parkourlrc/pcb-Pai-88--emg-robotic-hand-2f7e73264c/board/revd/kicad/release_20260804/bom.csv

Refs | Value | Footprint | Qty
C1,C2,C4,C6 | 100n | Capacitor_THT:C_Disc_D5.0mm_W2.5mm_P5.00mm | 4
C3 | 1u | Capacitor_THT:C_Rect_L7.0mm_W2.0mm_P5.00mm | 1
C5 | 10u | Capacitor_THT:CP_Radial_D5.0mm_P2.50mm | 1
C7 | 47p | Capacitor_THT:C_Disc_D5.0mm_W2.5mm_P5.00mm | 1
C8 | 470u | Capacitor_THT:CP_Radial_D10.0mm_P5.00mm | 1
D1,D2 | BAT85 | Diode_THT:D_DO-35_SOD27_P7.62mm_Horizontal | 2
J1 | Electrodes | Connector_PinHeader_2.54mm:PinHeader_1x03_P2.54mm_Vertical | 1
J2 | Pico / RP2040 | emg:Pico_Socket_2x1x20 | 1
J4 | +9/GND/-9 | TerminalBlock_Phoenix:TerminalBlock_Phoenix_MPT-0,5-3-2.54_1x03_P2.54mm_Horizontal | 1
J5 | Servo 1 | Connector_PinHeader_2.54mm:PinHeader_1x03_P2.54mm_Vertical | 1
J6 | Servo 2 | Connector_PinHeader_2.54mm:PinHeader_1x03_P2.54mm_Vertical | 1
J7 | Servo 3 | Connector_PinHeader_2.54mm:PinHeader_1x03_P2.54mm_Vertical | 1
J8 | Servo 4 | Connector_PinHeader_2.54mm:PinHeader_1x03_P2.54mm_Vertical | 1
J9 | Servo 5 | Connector_PinHeader_2.54mm:PinHeader_1x03_P2.54mm_Vertical | 1
J10 | +5V servo in | TerminalBlock_Phoenix:TerminalBlock_Phoenix_MPT-0,5-2-2.54_1x02_P2.54mm_Horizontal | 1
R1,R2,R4,R10 | 1k | Resistor_THT:R_Axial_DIN0207_L6.3mm_D2.5mm_P10.16mm_Horizontal | 4
R3 | 8.2k | Resistor_THT:R_Axial_DIN0207_L6.3mm_D2.5mm_P10.16mm_Horizontal | 1
R5 | 15k | Resistor_THT:R_Axial_DIN0207_L6.3mm_D2.5mm_P10.16mm_Horizontal | 1
R6 | 3.6k | Resistor_THT:R_Axial_DIN0207_L6.3mm_D2.5mm_P10.16mm_Horizontal | 1
R7,R8 | 10k | Resistor_THT:R_Axial_DIN0207_L6.3mm_D2.5mm_P10.16mm_Horizontal | 2
R9 | 5.1k | Resistor_THT:R_Axial_DIN0207_L6.3mm_D2.5mm_P10.16mm_Horizontal | 1
R11,R12 | 150k | Resistor_THT:R_Axial_DIN0207_L6.3mm_D2.5mm_P10.16mm_Horizontal | 2
R13 | 3.9M | Resistor_THT:R_Axial_DIN0207_L6.3mm_D2.5mm_P10.16mm_Horizontal | 1
R14 | 390k | Resistor_THT:R_Axial_DIN0207_L6.3mm_D2.5mm_P10.16mm_Horizontal | 1
R15 | 0R | Resistor_THT:R_Axial_DIN0207_L6.3mm_D2.5mm_P10.16mm_Horizontal | 1
U1 | AD623AN | Package_DIP:DIP-8_W7.62mm | 1
U2 | MCP6004 | Package_DIP:DIP-14_W7.62mm | 1
