parkourlrc/pcb-Pai-88--emg-robotic-hand-2f7e73264c/board/revd/kicad/release_20260804/board.step

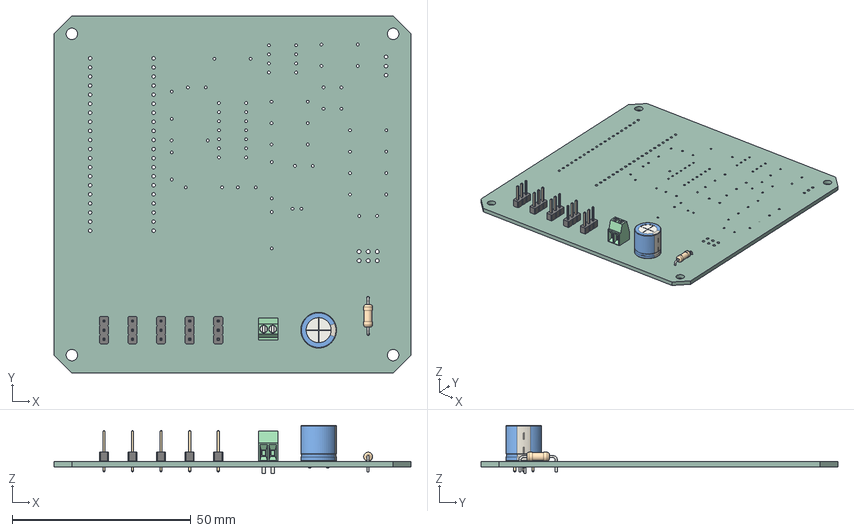
[picture p3: CAD file, 2026-08-05]
board/revd/kicad/release_20260804/board.step
100.0 x 100.0 x 13.5 mm
CP_Radial_D100mm_P500mm
PinHeader_1x03_P254mm_Vertical x 5
TerminalBlock_Phoenix_MPT-0,5-2-2.54_1x02_P2.54mm_Horizontal
R_Axial_DIN0207_L63mm_D25mm_P1016mm_Horizontal
emg_PCB
