parkourlrc/pcb-Pai-88--emg-robotic-hand-2f7e73264c/(list of files, cad)

Other CAD files:
board/revd/kicad/release_20260805/board.step
