parkourlrc/pcb-Pai-88--emg-robotic-hand-2f7e73264c/docs/wiring/main.pdf

# EMG Robotic Hand – Hardware Connection Map

How the board, microcontrollers, host and actuators wire together · rev E

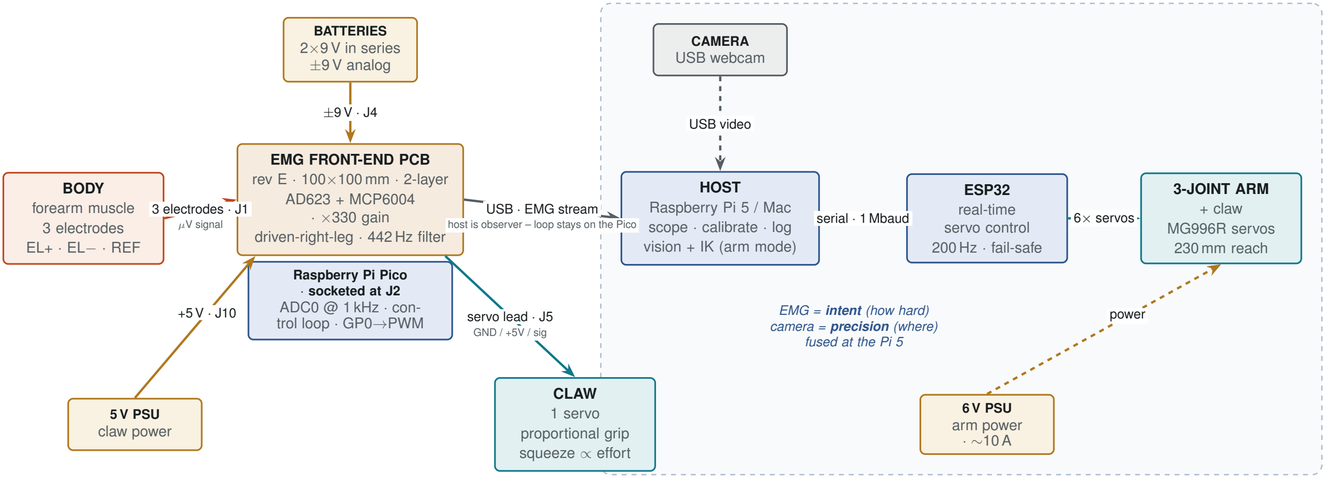
[picture p4: figure]
EMG FRONT-END PCB rev E · 100×100 mm · 2-layer AD623 + MCP6004 · ×330 gain driven-right-leg · 442 Hz filter; Raspberry Pi Pico · socketed at J2 ADC0 @ 1 kHz · con- trol loop · GP0→PWM; BODY forearm muscle 3 electrodes EL+ · EL− · REF; BATTERIES 2×9 V in series ±9 V analog; 5 V PSU claw power; CLAW 1 servo proportional grip squeeze ∝ effort; HOST Raspberry Pi 5 / Mac scope · calibrate · log vision + IK (arm mode); CAMERA USB webcam; ESP32 real-time servo control 200 Hz · fail-safe; 3-JOINT ARM + claw MG996R servos 230 mm reach; 6 V PSU arm power · ∼10 A; 3 electrodes · J1; µV signal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

host is observer – loop stays on the Pico

SUBSYSTEM A – built & verified

EMG → claw · rev E board + Pico + host

SUBSYSTEM B – proposed extension

+ camera + 3-joint arm (from the gripper project)

LINE | solid = built & verified | dashed = proposed integration
COLOUR | EMG signal (µV) | servo / actuation | power | data / USB

Designed & bench-tested in software / CAD – never fabricated, assembled, or powered. Battery only whenever electrodes are on skin: the device never shares ground with the mains.
