parkourlrc/pcb-Pai-88--emg-robotic-hand-2f7e73264c/board/revd/kicad/emg-revD-schematic.pdf

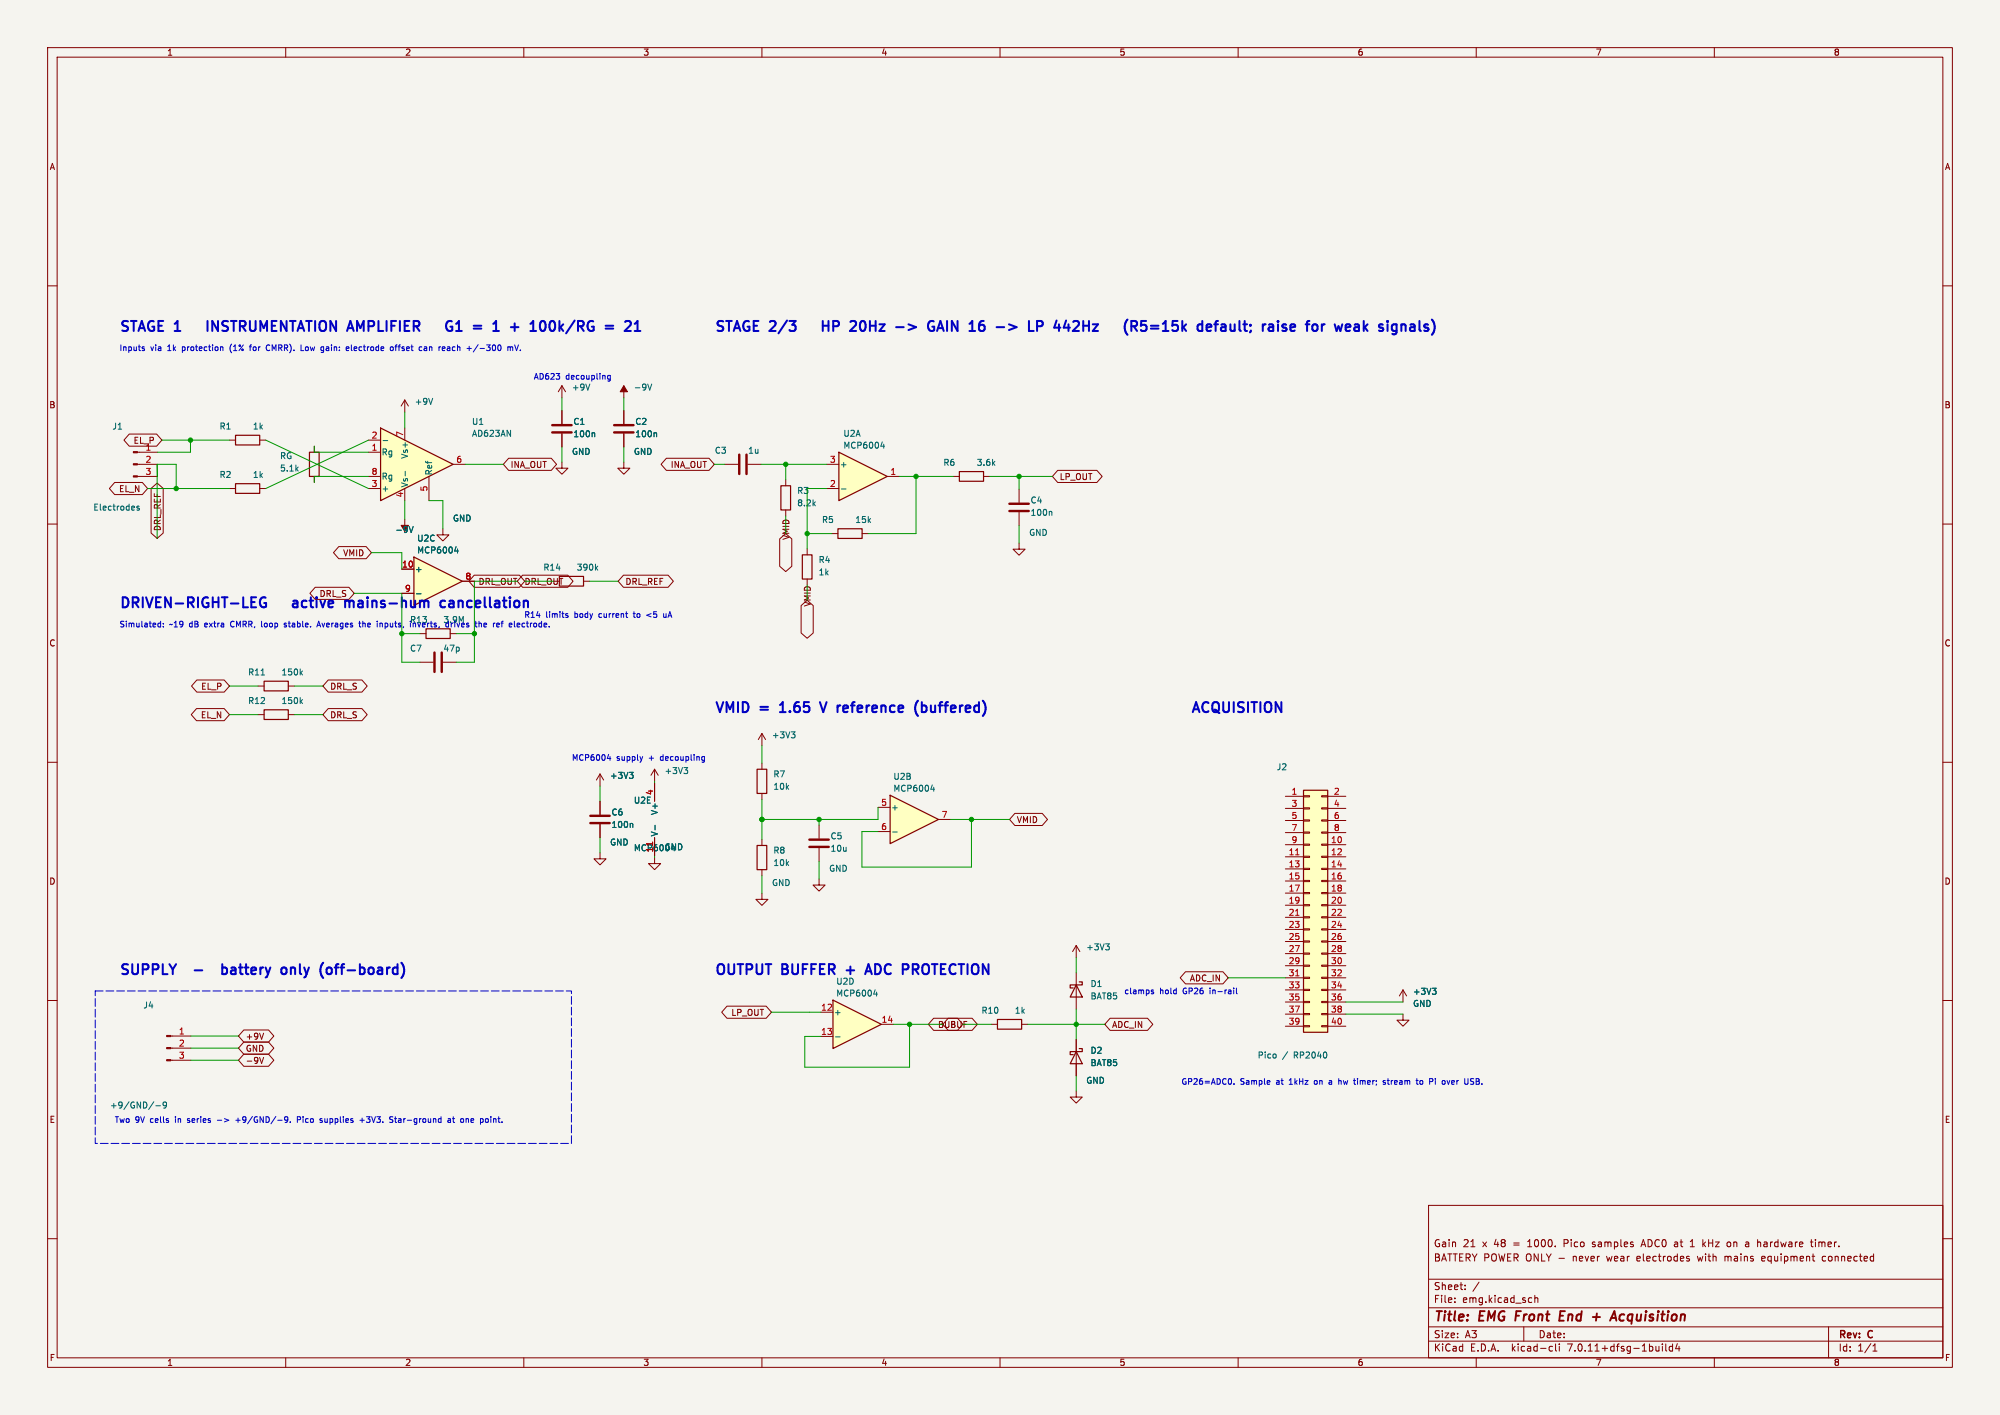
[picture p5: page 1]

clamps hold GP26 in-rail VMID = 1.65 V reference (buffered)

GP26=ADC0. Sample at 1kHz on a hw timer; stream to Pi over USB.

Id: 1/1 Title: EMG Front End + Acquisition
