parkourlrc/pcb-Pai-88--emg-robotic-hand-2f7e73264c/board/revd/kicad/release_20260804/top.pdf

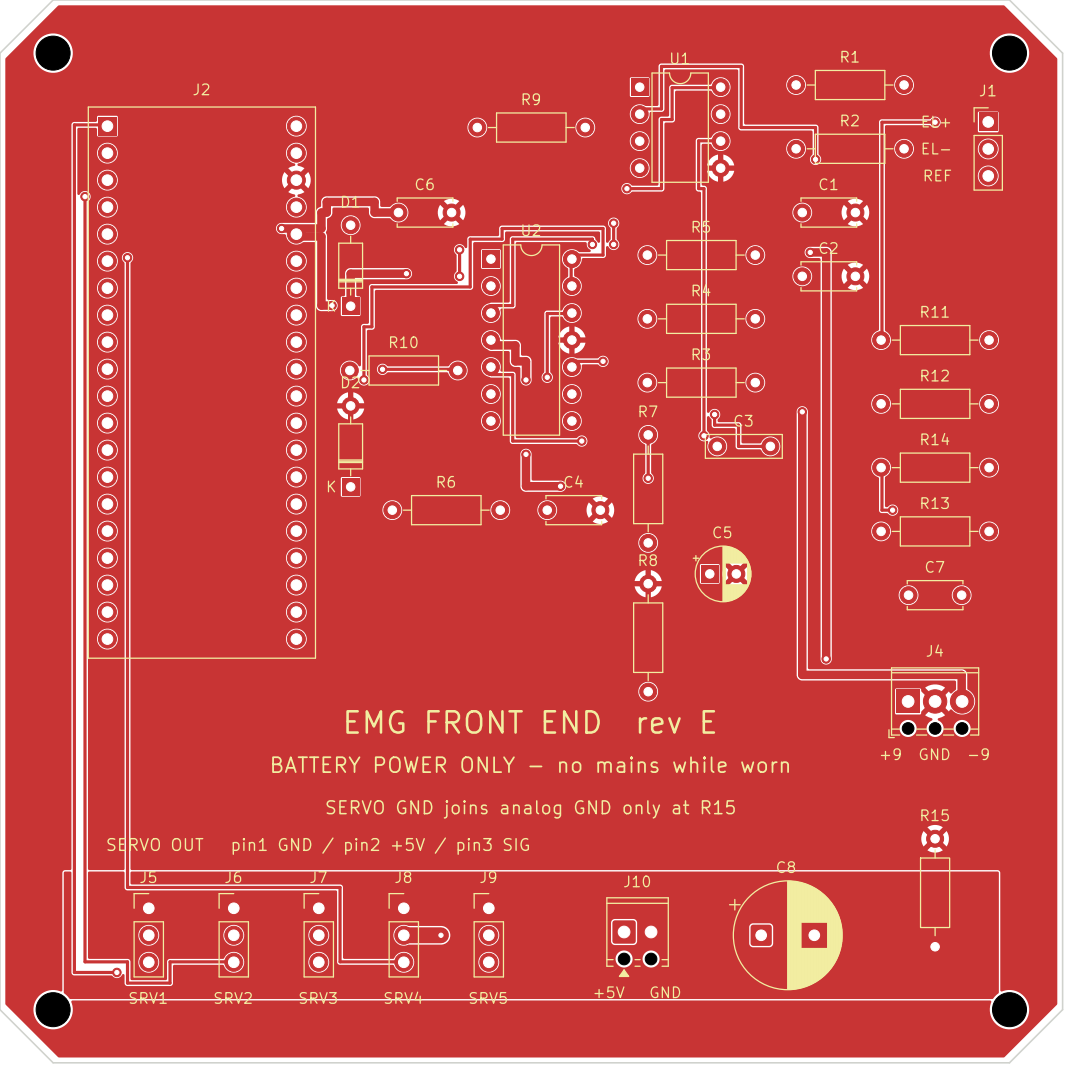
[picture p6: page 1]
