parkourlrc/pcb-Pai-88--emg-robotic-hand-2f7e73264c/board/revd/kicad/release_20260805/top.pdf

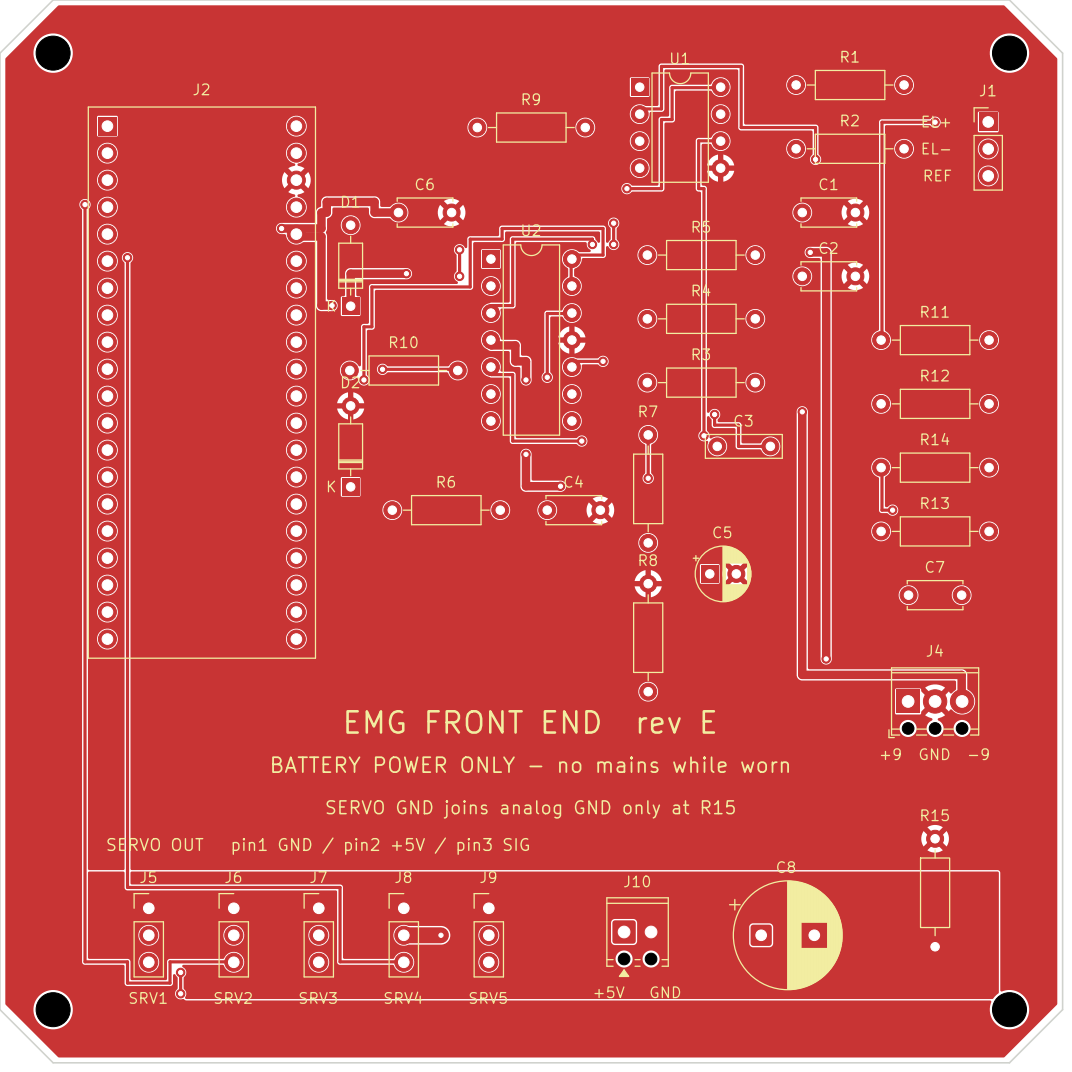
[picture p7: page 1]
