parkourlrc/pcb-Pai-88--emg-robotic-hand-2f7e73264c/board/revd/kicad/emg.kicad_pcb

## KiCad design board/revd/kicad/emg.kicad_pcb (2026-08-05)

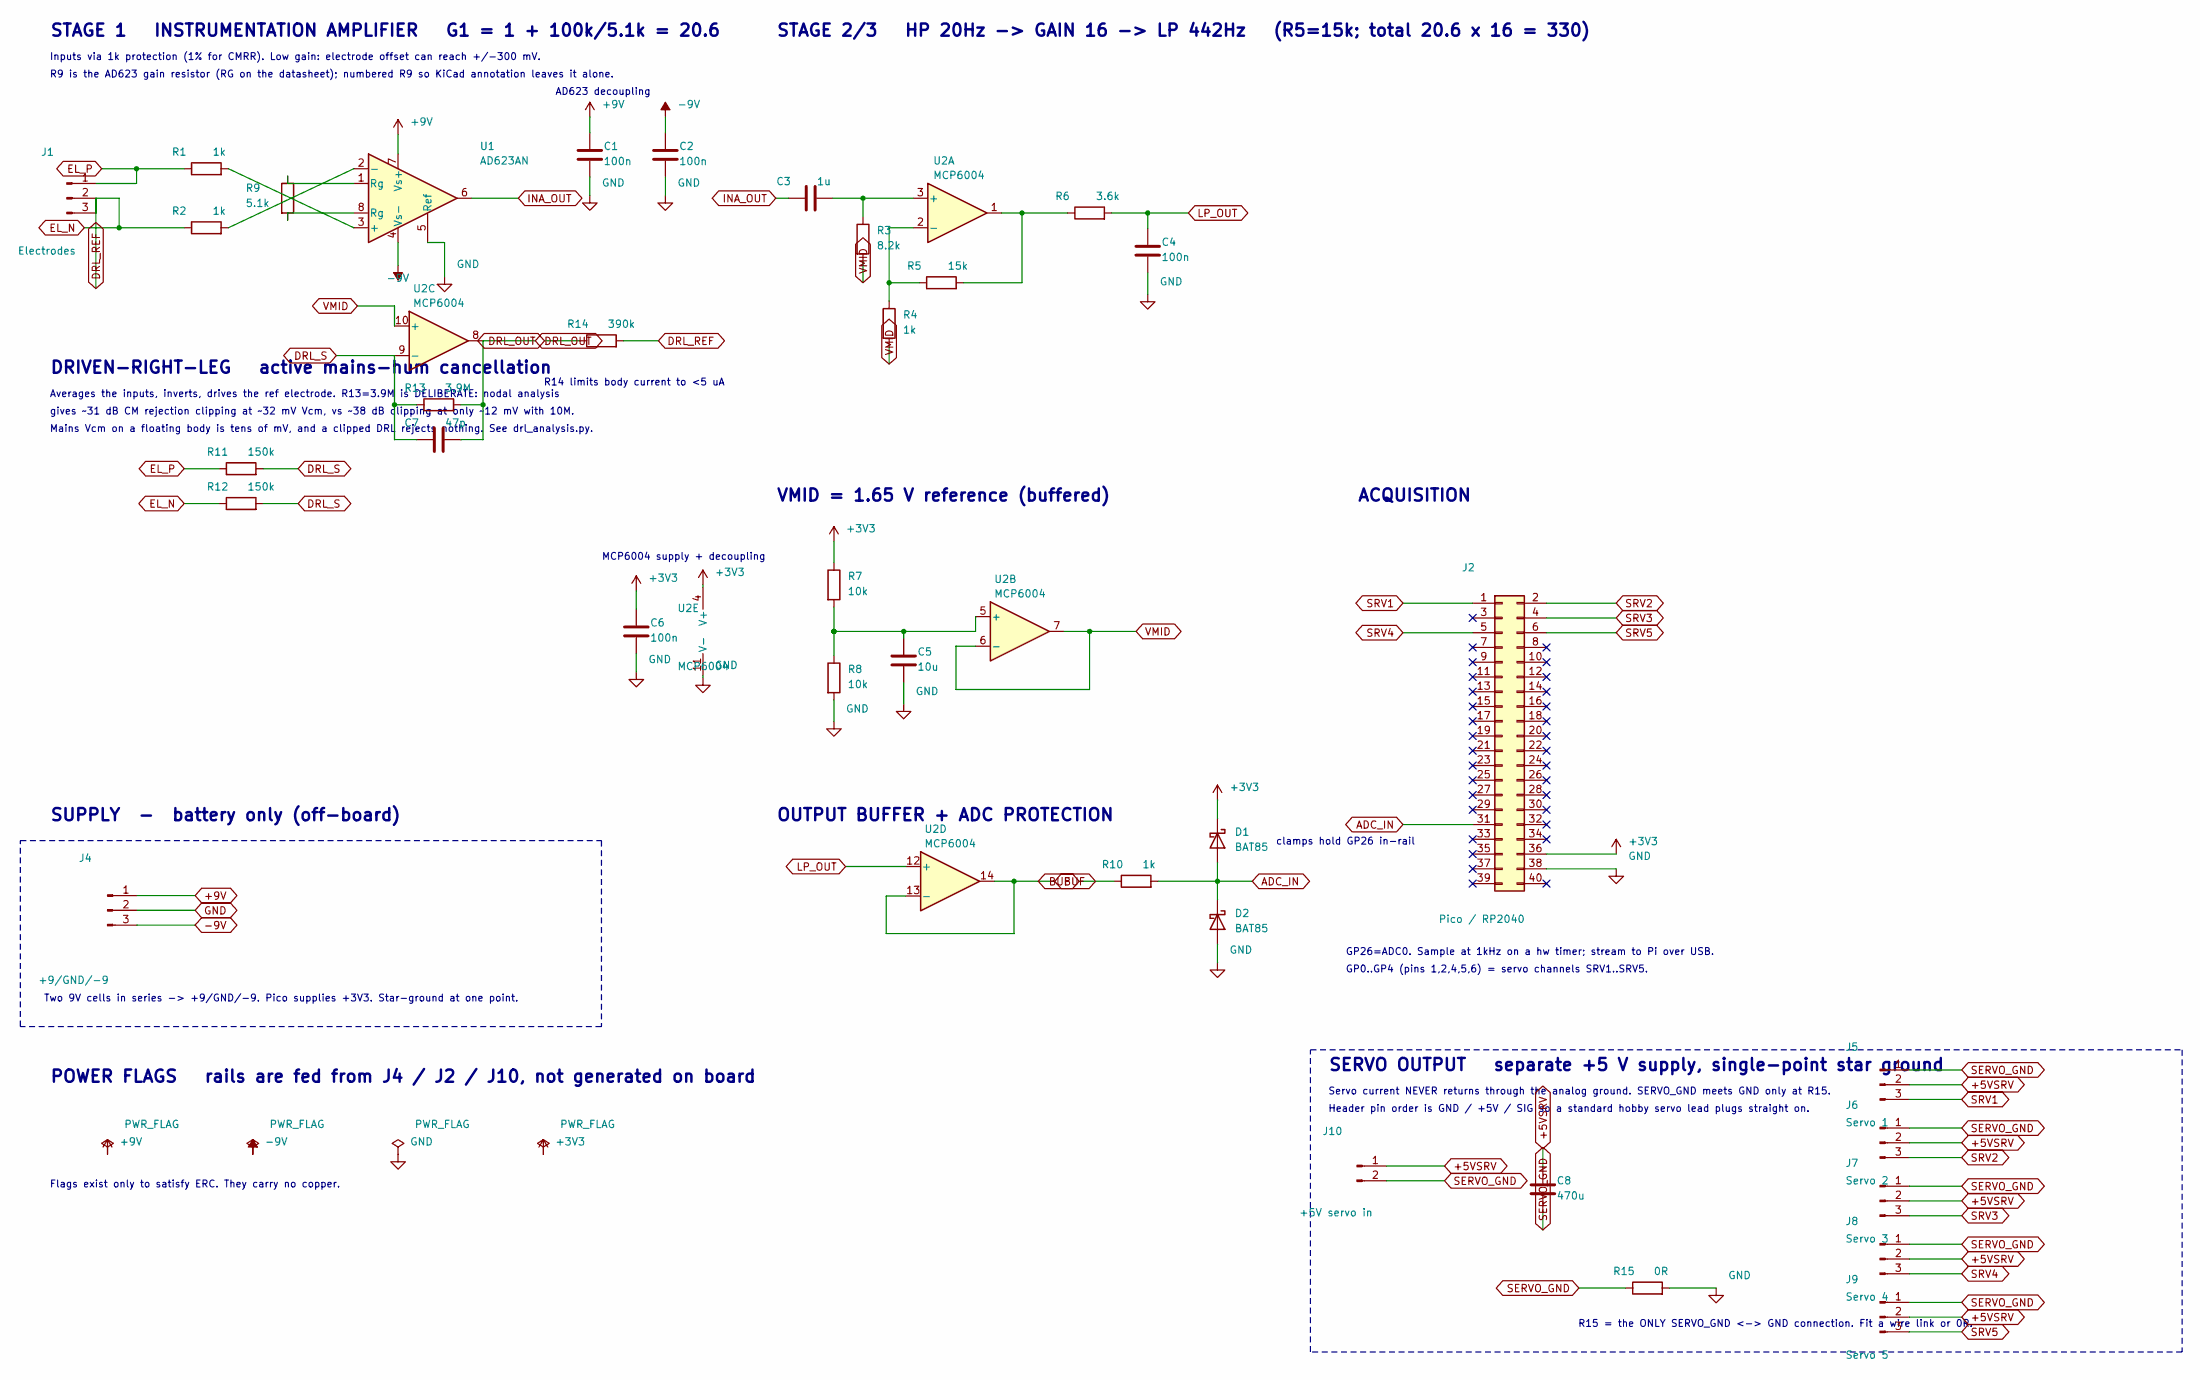
[picture p8: schematic emg.kicad_sch, EMG Front End + Acquisition]

Parts:
C1, C2, C4, C6: 100n; C_Disc_D5.0mm_W2.5mm_P5.00mm
C3: 1u; C_Rect_L7.0mm_W2.0mm_P5.00mm
C5: 10u; CP_Radial_D5.0mm_P2.50mm
C7: 47p; C_Disc_D5.0mm_W2.5mm_P5.00mm
C8: 470u; CP_Radial_D10.0mm_P5.00mm
D1, D2: BAT85; D_DO-35_SOD27_P7.62mm_Horizontal
J1: Electrodes; PinHeader_1x03_P2.54mm_Vertical
J2: Pico / RP2040; Pico_Socket_2x1x20
J4: +9/GND/-9; TerminalBlock_Phoenix_MPT-0,5-3-2.54_1x03_P2.54mm_Horizontal
J5: Servo 1; PinHeader_1x03_P2.54mm_Vertical
J6: Servo 2; PinHeader_1x03_P2.54mm_Vertical
J7: Servo 3; PinHeader_1x03_P2.54mm_Vertical
J8: Servo 4; PinHeader_1x03_P2.54mm_Vertical
J9: Servo 5; PinHeader_1x03_P2.54mm_Vertical
J10: +5V servo in; TerminalBlock_Phoenix_MPT-0,5-2-2.54_1x02_P2.54mm_Horizontal
R1, R2, R4, R10: 1k; R_Axial_DIN0207_L6.3mm_D2.5mm_P10.16mm_Horizontal
R3: 8.2k; R_Axial_DIN0207_L6.3mm_D2.5mm_P10.16mm_Horizontal
R5: 15k; R_Axial_DIN0207_L6.3mm_D2.5mm_P10.16mm_Horizontal
R6: 3.6k; R_Axial_DIN0207_L6.3mm_D2.5mm_P10.16mm_Horizontal
R7, R8: 10k; R_Axial_DIN0207_L6.3mm_D2.5mm_P10.16mm_Horizontal
R9: 5.1k; R_Axial_DIN0207_L6.3mm_D2.5mm_P10.16mm_Horizontal
R11, R12: 150k; R_Axial_DIN0207_L6.3mm_D2.5mm_P10.16mm_Horizontal
R13: 3.9M; R_Axial_DIN0207_L6.3mm_D2.5mm_P10.16mm_Horizontal
R14: 390k; R_Axial_DIN0207_L6.3mm_D2.5mm_P10.16mm_Horizontal
R15: 0R; R_Axial_DIN0207_L6.3mm_D2.5mm_P10.16mm_Horizontal
U1: AD623AN; DIP-8_W7.62mm
U2: MCP6004; DIP-14_W7.62mm

Connections:
+3V3: C6.1, D1.1 (K), J2.36, R7.1, U2.4 (V+)
+5VSRV: C8.1, J5.2, J6.2, J7.2, J8.2, J9.2, J10.1
+9V: C1.1, J4.1, U1.7 (Vs+)
-9V: C2.1, J4.3, U1.4 (Vs-)
ADC_IN: D1.2 (A), D2.1 (K), J2.31, R10.2
BUF: R10.1, U2.13 (-), U2.14
DRL_OUT: C7.2, R13.2, R14.1, U2.8
DRL_REF: J1.3, R14.2
DRL_S: C7.1, R11.2, R12.2, R13.1, U2.9 (-)
EL_N: J1.2, R2.1, R12.1
EL_P: J1.1, R1.1, R11.1
GND: C1.2, C2.2, C4.2, C5.2, C6.2, D2.2 (A), J2.38, J4.2, R8.2, R15.2, U1.5 (Ref), U2.11 (V-)
INA_OUT: C3.1, U1.6
LP_OUT: C4.1, R6.2, U2.12 (+)
unnamed: R5.2, R6.1, U2.1
unnamed: R9.1, U1.1 (Rg)
unnamed: R9.2, U1.8 (Rg)
unnamed: R1.2, U1.3 (+)
unnamed: R2.2, U1.2 (-)
unnamed: C3.2, R3.1, U2.3 (+)
unnamed: R4.1, R5.1, U2.2 (-)
unnamed: C5.1, R7.2, R8.1, U2.5 (+)
SERVO_GND: C8.2, J5.1, J6.1, J7.1, J8.1, J9.1, J10.2, R15.1
SRV1: J2.1, J5.3
SRV2: J2.2, J6.3
SRV3: J2.4, J7.3
SRV4: J2.5, J8.3
SRV5: J2.6, J9.3
VMID: R3.2, R4.2, U2.6 (-), U2.7, U2.10 (+)

Notes on the sheet:
STAGE 1 INSTRUMENTATION AMPLIFIER G1 = 1 + 100k/5.1k = 20.6
Inputs via 1k protection (1% for CMRR). Low gain: electrode offset can reach +/-300 mV.
R9 is the AD623 gain resistor (RG on the datasheet); numbered R9 so KiCad annotation leaves it alone.
AD623 decoupling
DRIVEN-RIGHT-LEG active mains-hum cancellation
Averages the inputs, inverts, drives the ref electrode. R13=3.9M is DELIBERATE: nodal analysis
gives ~31 dB CM rejection clipping at ~32 mV Vcm, vs ~38 dB clipping at only ~12 mV with 10M.
Mains Vcm on a floating body is tens of mV, and a clipped DRL rejects nothing. See drl_analysis.py.
R14 limits body current to <5 uA
STAGE 2/3 HP 20Hz -> GAIN 16 -> LP 442Hz (R5=15k; total 20.6 x 16 = 330)
VMID = 1.65 V reference (buffered)
OUTPUT BUFFER + ADC PROTECTION
clamps hold GP26 in-rail
MCP6004 supply + decoupling
SUPPLY - battery only (off-board)
Two 9V cells in series -> +9/GND/-9. Pico supplies +3V3. Star-ground at one point.
ACQUISITION
GP26=ADC0. Sample at 1kHz on a hw timer; stream to Pi over USB.
GP0..GP4 (pins 1,2,4,5,6) = servo channels SRV1..SRV5.
SERVO OUTPUT separate +5 V supply, single-point star ground
Servo current NEVER returns through the analog ground. SERVO_GND meets GND only at R15.
Header pin order is GND / +5V / SIG so a standard hobby servo lead plugs straight on.
R15 = the ONLY SERVO_GND <-> GND connection. Fit a wire link or 0R.
POWER FLAGS rails are fed from J4 / J2 / J10, not generated on board
Flags exist only to satisfy ERC. They carry no copper.

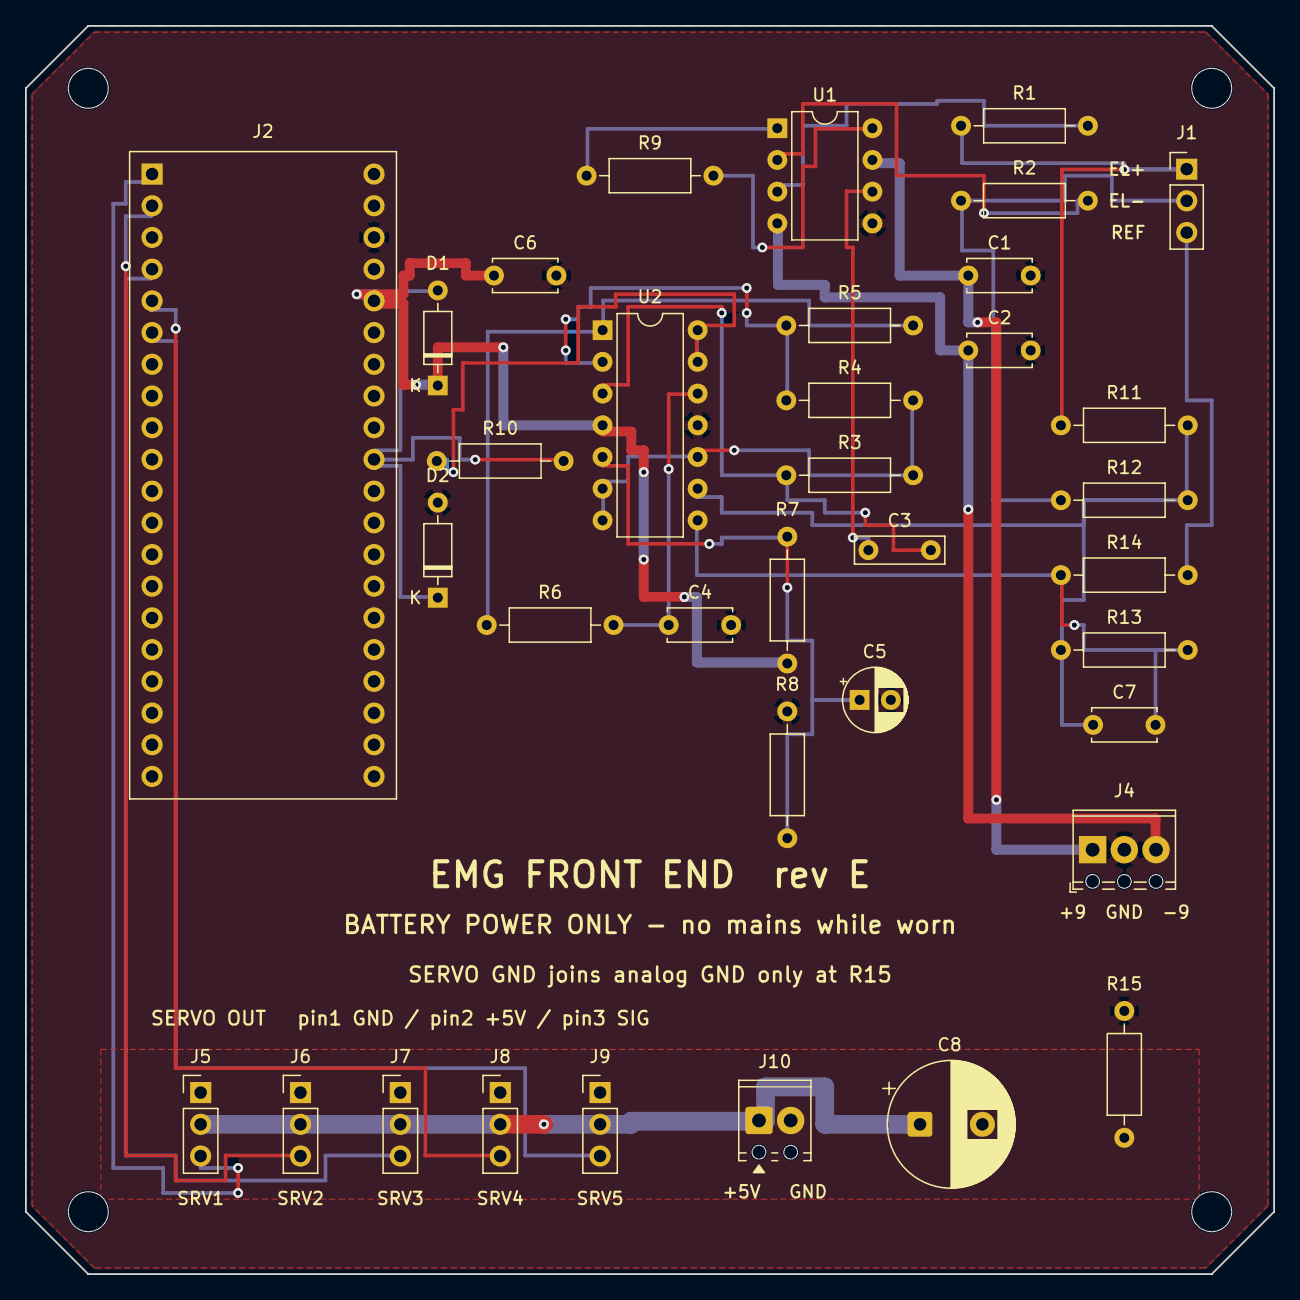
[picture p9: board emg.kicad_pcb from above]

Board: 2 copper layers, 100.0 x 100.0 mm, 40 parts (0 on the bottom side), 29 nets.

Other parts of the board:
H1, H2, H3, H4: MountingHole_3.2mm_M3
